maier-laurin/Cave_Lidar/Lidar.stl

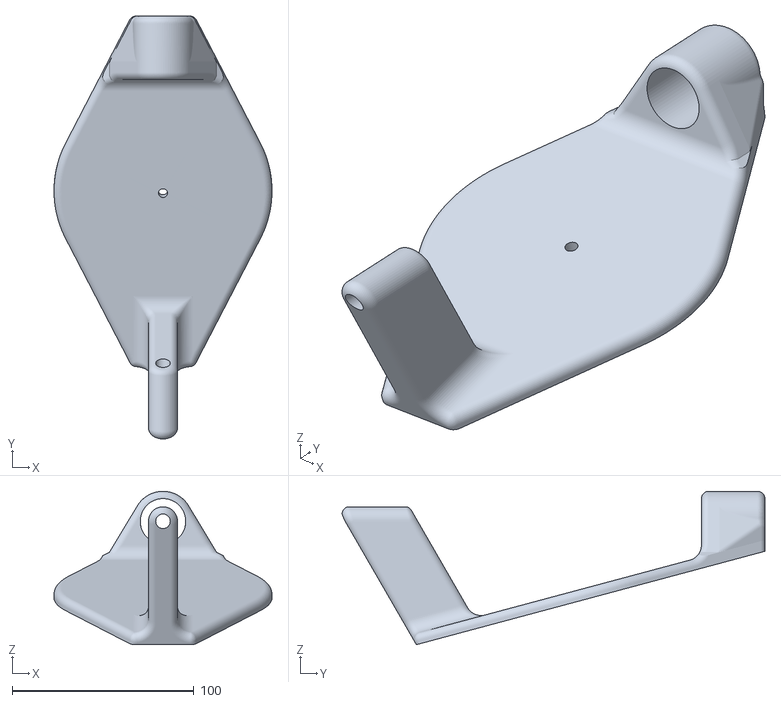
[picture p2: CAD file, 2026-02-03]
Lidar.stl
120.0 x 232.8 x 84.4
