maier-laurin/Cave_Lidar/(list of files, cad)

Other CAD files:
cad/drawings.dwg
Models/Assambly.dwg
Zeichnung1.dwg
