maier-laurin/Cave_Lidar/Documentation/figures/Drawings-welle.pdf

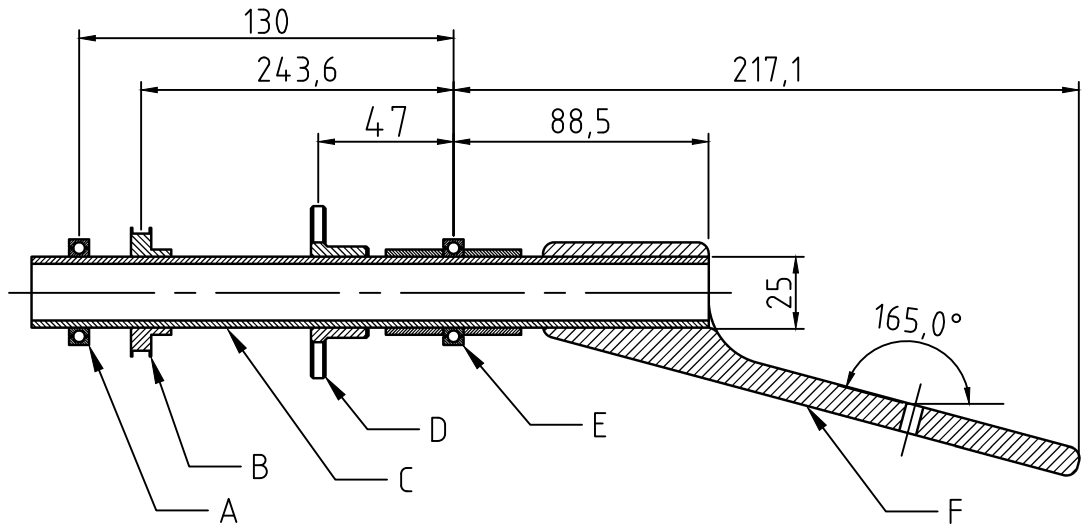
[picture p3: page 1]
