maier-laurin/Cave_Lidar/(commit log)

2026-02-04 New assambly
    [Assambly.dwg, Lidar.stl, Zeichnung1.dwg]
2026-02-05 Dual quaternions library optimiced for the usecase
    [Lidar.stl, Zeichnung1.dwg]
2026-10-08 Snapshot: firmware, docs, assembly and drawings before cleanup
2026-10-08 Clean up repo: keep rig CAD, final firmware and docs, restructure folders
    - cad/: assembly, drawings, VLP-16 reference model (lowercase names)
    - firmware/: lidar_ctrl sketch and WIRING.md only
    - docs/: Typst engineering document
    - remove old acquisition/fusion/post-processing code and scratch files
    (still available in history, see 4cd3fc0)
    - recorded sensor data moved to untracked data/
    Claude-Session: https://claude.ai/code/session_01LBUSwPCoYHZyMpNxgCLWYQ
2026-10-08 Move wiring documentation into the Typst document, remove WIRING.md
    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
2026-10-08 Document the control firmware in the Typst manual
    Replace the outdated control software chapter with a full description of
    lidar_ctrl: operation and commands, parameters, step generation, index
    sensor and shaft angle, PPS/NMEA time base, IMU, USB packet format and
    known limitations.
    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
2026-10-09 Add C# lidar recorder (VLP-16 to Arrow stream files) and document it
    capture/ holds a LidarCapture library, a console program (record, inspect,
    sniff, optional rig start over serial) and xunit tests. Points are stored in
    spherical coordinates with absolute per-point UTC time: sub-second phase from
    the PPS-locked lidar, whole seconds from a rough reference clock. Tested on
    the real rig: 0 lost packets, correct absolute times.
    The Typst manual gets the lidar network settings, the capture software
    chapter and the time handling.
    Claude-Session: https://claude.ai/code/session_01SPaSV8HPij5Nzw8maY7BJj
2026-10-09 Add rig recorder and CaveScan orchestrator, fix lidar clock overflow
    - CaptureCore: shared chunked Arrow stream writer (lidar writer now uses it)
    - TeensyCapture: packet parser (CRC, resync), serial link with live state and
    a drift-free time reference, recording of samples/edges/messages
    - CaveScan: CLI orchestrator with project/scan folders, rig start/stop,
    lidar PPS-lock wait, live dashboard, scan.json, unattended --auto mode
    - LidarRecorder: continuous check of the lidar time against the reference
    - Fix: hour-wrap detection overflowed 32 bits once the lidar was more than
    41 minutes into its hour (found by the live time check), with a test
    - Document the new modules in the Typst manu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
2026-10-10 Rig stream protocol 2 with gyroscope, index offset 90.3 deg, recorder header fix
    Firmware: calibrated gyroscope (gx, gy, gz, cal2) appended to the 'S' packet (70 bytes, the first 57 are unchanged), a 5 s message with the number of IMU reports received per type, VERTICAL_AFTER_EDGE_DEG 93.0 -> 90.3 (a floor scan showed the zero position 2.7 deg off). The game rotation vector is deliberately not enabled: with it the normal rotation vector stopped arriving.
    Capture: the decoder reads protocol 1 and 2, the rig Arrow files get the gyroscope columns (cave_lidar.rig/2), the dashboard shows magnetometer and gyro status. The first rig chunk is no longer written before the stream header arrived, so it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
2026-10-10 Add BNO085 calibration helper sketch
    Runs the BNO085 with dynamic calibration of accelerometer, gyroscope and magnetometer on, prints the calibration state, field strength, heading and tilt on USB serial, stores the calibration to the BNO flash (automatically after 10 s at magnetometer 3/3, or on 's').
    Claude-Session: https://claude.ai/code/session_01AZMYEKnhkDoNdMS2K3XqRk
2026-10-10 Add CaveLidarRecon: untangling of the shaft rotation plus IMU attitude
    Julia package that turns the Arrow files of a scan folder into one untangled.arrow (time in ns, x, y, z, reflectivity). Port of the deskew experiment (exact parity), per-point BNO attitude by slerp in gravity mode (default, only the tilt: up onto +Z, heading untouched) or world mode (ENU), vertical offset read from the rig file metadata (93 deg for old recordings), BNO mount calibration script with a tilt-only mode (the stored 5.6 deg tilt is set aside as bno_mount.toml.disabled, the mounting is assumed flat), tests.
    Claude-Session: https://claude.ai/code/session_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
2026-10-10 Document the reconstruction, BNO calibration, protocol 2 and the index offset
    Reconstruction chapter: modes, floor-plane check and results, the offset error, BNO mounting and magnetic heading findings, open points. Firmware chapter: command line build, helper sketch. README layout.
    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
2026-10-11 Add window and spline odometry, simulation, path viewer; full-density PLY export; add older project folders
